BruBread/LWeek2026/puzzle4-orbit-lock/controller_esp32/secrets.h

// Wi-Fi networks, in order of preference. Each ip must be free on that network and sit in its router's subnet.
Net NETS[] = {
  { "NexusV",     "aurorawashere",     IPAddress(192, 168, 0, 52), IPAddress(192, 168, 0, 1) },
};
