BruBread/LWeek2026/(commit log)

2026-10-02 Initial commit: NEXUS escape room for LWeek 2026
    Four networked escape-room games, a WebSocket hub with a GM panel, ESP32 prop sketches and the signup kiosk. Wi-Fi credentials, the bulb key, the camera account and the kiosk staff password live in untracked files (secrets.h, devices.json, camera.json, pin.txt).
2026-10-03 Add game 5 finale, game 4 controllers and strip, booth install scripts
    Game 5 "Everywhere At Once" (hub/public/boss.js, loaded into every room page from the hub):
    - Game 4's win is fake: AURORA TERMINATED, the save stalls at 97%, the screen crashes
    - Aurora talks in an Undertale-style dialogue box, then takes over every room at one hub time
    - Room 3 becomes the map; rooms 1, 2, 4 get her tasks (binary, hard words, two-knob crosshair)
    - Rooms 1 and 2 swap tasks once; everyone regroups at the map for the briefing
    - Kill switch: rooms 1, 2, 4 press together, judged on a hub-synced clock (TRACE sets the window)
    - Hub owns the finale state (rejoin after reload, survives a hub restart); FINISH RUN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
    [beacon_esp32.ino]
2026-10-04 Add FreshStart.bat, bundle go2rtc, finale portraits and GM panel updates
    FreshStart.bat installs Git, Node.js, Python, the bridge packages (now
    including bleak for the game 4 laser strip), firewall rules and the hub's
    npm packages on a bare Windows machine. Install.bat calls it instead of
    repeating those steps.
    go2rtc.exe is now tracked so the camera pop-up works from a plain clone.
    Update.bat no longer reports go2rtc.exe or the unused pin.txt as missing.
2026-10-04 Track booth credentials, drop the backup Wi-Fi networks
    secrets.h (both ESP32 sketches), devices.json (hallway bulb key) and
    camera.json (hallway camera login) are now in the repo, so a clone runs
    without the flash drive. The ESP32s keep only NexusV: the walawifi and
    secretwifi entries are gone, along with the 192.168.1.x addresses the
    pages sent to and the secrets.example.h templates.
    Update.bat no longer copies secrets from the flash drive.
    [beacon_esp32.ino, mask_esp32.ino, secrets.h]
2026-10-04 Game 4: one Wi-Fi controller with fire wires and a screen
    - One ESP32 on a breadboard replaces the two ring controllers: both knobs,
    two fire wires (touch and hold to fire), a 1.3" SH1106 OLED (spinner,
    FIRE on shots) and a red not-on-Wi-Fi LED, all wired on the VIN side.
    - Joins NexusV at 192.168.0.52 and streams readings over Server-Sent
    Events; USB Web Serial stays as a backup.
    - The game sends FIRE back so the screen only flashes on real shots, and
    its labels switch between the controller and the keys.
    - The GM panel pings the controller itself, so its light works with the
    P4 game closed.
    [controller_esp32.ino, secrets.h]
2026-10-04 Game 4: rings follow their knobs, smooth knobs, interactive training
    - Each ring is its knob: the gap points where the knob's mark points, in
    every layer. Layers move the laser instead (new spot, Aurora drags it in
    DRIFT/WATCHDOGS, thrown after misses in OVERRIDE).
    - Knob readings glide into place, and the controller keeps Wi-Fi power
    saving off, so the rings turn smoothly.
    - Interactive training before layer 1: turn the outer knob, turn the inner
    knob, point both gaps at the laser, touch the two wires together.
    - Controller: walawifi fallback after 4 s without NexusV, red LED blinks
    with FIRE. Game 4 and the GM panel look for it on both networks.
    - booth.bat detects the laptop's n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
    [controller_esp32.ino]
2026-10-04 Game 3: blue LEDs, 3 faster layers, walawifi backup; game 1 fake desktop and other booth updates
    - Game 3 (Hidden Signal): IR LEDs replaced by blue LEDs. Three layers, each a
    new code blinked faster; the last one is too fast for the eye and needs a
    phone's slow-motion video. Digits 2-5 only, so 111 is a trap that brings the
    first hint. Blink timing lives in CFG.ROUNDS and is sent with every code, so
    the board never needs a reflash to tune it. Phone stand-in follows the same
    timing. Beacon falls back to walawifi (192.168.1.51) like game 4's controller.
    - Game 1: fake Windows desktop (desktop.html), projector below the laptop.
    - Finale, game 2, game 4 controller, GM panel and signup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
    [beacon_esp32.ino, controller_esp32.ino, secrets.h]
2026-10-04 Aurora's recorded voice in every game; GM sound pads, soundtrack and booth updates
    - Aurora speaks recorded ElevenLabs lines: aurora-voice/script.txt is the script,
    aurora-voice/cut.py cuts the take into clips (speech recognition + pauses) and
    makes them robotic and glitchy, into hub/public/voice/ with index.json.
    - hub/public/voice.js plays the clip for each line on every page (games 1-4,
    finale, dossier, signup kiosk); text types over the clip; no clip = blips.
    - GM panel sound effect pads (public/sfx, upload/delete/push) and room soundtracks
    played from the hub (game 2-4 tracks, boss fight, scream, hum).
    - Game 3 board/beacon updates, Game 4 single Wi-Fi controller, game 2 staff c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
    [beacon_esp32.ino, controller_esp32.ino]
2026-10-05 Game 1 stuck hint, game 3 old-sketch check, GM soundtrack for staff tests
    - Game 1: 60 s into the run with the mask still unclicked, the laptop
    wallpaper glitches to DRAG THE MOUSE DOWN (Binary Key is minimized) and
    the mask's red LED blinks until the mask is clicked. New /red endpoint
    in mask_esp32.ino (needs a reflash). Ctrl+Alt+D fires it now.
    - Game 3: the beacon answers with CORS so the game can tell beacon_esp32.ino
    from an older sketch; the GM panel and Ctrl+Alt+H show OLD SKETCH. The
    sketch prints the code it is blinking.
    - GM panel: with no team's run, the soundtrack follows the last moment a
    room sent, so staff tests get music.
    - Sound pads: replace the old sfx with LOO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
    [beacon_esp32.ino, mask_esp32.ino]
2026-10-05 Game 3: 2-step training, slow-motion hint; GM UPDATE ALL SYSTEMS over the booth Wi-Fi
    - Game 3: the typing practice step is gone. The training is COUNT THE BLINKS
    (demo 243) then FIND THE REAL ONE (blink-rate gauge), then the hunt.
    - Game 3: one hint in layer 3, MAYBE TRY A SLOW-MOTION CAMERA, 15 s in or
    right after the first wrong code there. It replaces the 40 s / 80 s ladder.
    - GM panel: UPDATE ALL SYSTEMS copies this laptop's version of the game to
    every laptop with a page on the hub, as a git bundle over the booth Wi-Fi
    (hub/updater.js, started by booth.bat on each laptop). Never moves a
    laptop backwards. Covered in hub/test.js.
2026-10-05 Game 5: 5 shared lives, YOU LOST ending, clearer kill switch; game 3 slower last layer + Ctrl+Alt+L
    - Finale: the team shares 5 lives (hub-owned). A failed kill switch, a wrong
    BINARY digit or a missed MIRRORS shot costs one; 0 lives = her losing
    dialogue and YOU LOST on every screen. Lives card at the takeover, a lives
    bar on every screen, full-screen -1 LIFE. GM card shows lives / SHE WON,
    history marks lost runs.
    - Room 3's kill switch screen: 4 numbered steps, SPACE runs a 3-2-1-NOW count.
    - Fix: rooms 1-3 skipped the takeover (treated it as a reload).
    - Game 3: last layer 50/60 ms (visible flicker, countable in slow-mo),
    Ctrl+Alt+L / GM SLOWER stretches the blinks x1.5 per pre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
2026-10-05 Day 1 fixes: 23-min run limit with TIME'S UP ending, GM message hints, game 3 slower by eye with I CAUGHT YOU, game 4 shorter training and no drift, controller Wi-Fi fix, kiosk restart key
    [beacon_esp32.ino, controller_esp32.ino, mask_esp32.ino]
2026-10-05 GM panel: add a BEARBOX device light for the ticket-sales display
2026-10-06 Hub keeps a laptop through 7 s of silence (a crowd's slow Wi-Fi dropped every laptop at the old 2 s cut), add wifi fix.bat to turn off Wi-Fi power saving
2026-10-06 GM panel LIGHTS pop-up (bulb on/off, color, brightness), free chat messages in room 2 too, clock counts down; game 2 whisper after the training and GM messages; game 3 board steady on during training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
2026-10-07 Day 3: game 1 Mind Upload (no second-screen trick), local laptop/wall link, finale QTEs; game 2 shorter training; MIRRORS 3 hits; hub win/lose sounds; camera aims for game 1/2
    - Game 1: centered Mind Upload app starts the wall's upload while the laptop shows a loading bar, then the binary key with 4 password boxes. The laptop keeps the keyboard and sends keys to the wall through puzzle1-brain-upload/server.js (replaces python http.server, works with the hub down). Browser shortcuts blocked (Ctrl+H, F5, F7). Mask click, hover glow and stuck hint removed. Finale attacks are SPAM SPACE / HOLD Q / SPAM E / HOLD SPACE. start.bat keeps the covered wall window animating (backgrounding flags).
    - GM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
2026-10-07 Hub no longer crashes on a bad WebSocket frame (its restart dropped every room), logs to hub/hub.log, keeps a silent laptop 15 s; pages wait 4 s for the saved hub before scanning the network
2026-10-10 Remove the backup Wi-Fi network: the beacon and the Orbit Lock controller join NexusV only; save the camera aims for games 1 and 2
2026-10-10 README: videos of a live run and the Room 4 controller, prop circuit photos with a pin table, signup kiosk screenshot
2026-10-10 Corrected ticket sales (₱20,000), inline videos, photo of the first infrared Room 3 beacon
